xuan25/IR-Controller-AC-YBOF2/Core/Src/main.c

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
/* Includes ------------------------------------------------------------------*/
#include "main.h"
#include "i2c.h"
#include "tim.h"
#include "gpio.h"

/* USER CODE BEGIN Includes */
#include <stdio.h>
#include "aht20.h"
#include "hpt.h"
#include "oled.h"
#include "binary_push_key.h"
#include "pushable_dial.h"

/* USER CODE END Includes */

/* USER CODE BEGIN PD */
#define CMD_INTERVAL 60 * 1000 
#define HT_INTERVAL 1500 
#define HT_READ_DELAY 80
/* USER CODE END PD */


void SystemClock_Config(void);
/* USER CODE BEGIN 0 */
uint32_t cmdOn[] = { 0x9000000A, 0x0004000A };
uint32_t cmdOff[] = { 0x8000000A, 0x0004000B };

uint32_t cmd[2];
uint32_t cmdSegIdx = 0;
uint32_t segBitIdx = 0;

uint64_t lastBitReceivedUs = 0;

uint32_t lastHTMeasureMs = -HT_INTERVAL;
uint32_t lastHTReadMeasureMs = -HT_INTERVAL;

uint32_t lastCmdSentMs = -CMD_INTERVAL;

float tempLower = 26.5;
float tempUpper = 27.5;

BinaryPushKey keys[];
PushableDial dial;

void HAL_GPIO_EXTI_Callback(uint16_t GPIO_Pin)
{
  if(GPIO_Pin == GPIO_PIN_1)
  {
    uint64_t currentUs = HPT_GetUs();
    uint64_t deltaUs = HPT_DeltaUs(lastBitReceivedUs, currentUs);
    lastBitReceivedUs = currentUs;
    if (deltaUs > 4000)
    {
      // beginning of the transmit
      segBitIdx = 0;
      cmdSegIdx++;
      if (cmdSegIdx == 2) {
        cmdSegIdx = 0;
        cmd[0] = 0;
        cmd[1] = 0;
      }
    }
    else if (deltaUs > 1700)
    {
      // bit-1
      if (segBitIdx < 32) {
        segBitIdx++;
        cmd[cmdSegIdx] |= (1UL << (32 - segBitIdx));   // write 1
      }
      
    }
    else if (deltaUs > 1000)
    {
      // bit-0
      if (segBitIdx < 32) {
        segBitIdx++;
        cmd[cmdSegIdx] &= ~(1UL << (32 - segBitIdx));   // write 0
      }
    }
    if (cmdSegIdx == 1 && segBitIdx == 32) {
      cmdSegIdx = 0;
      segBitIdx = 0;
    }
  }
  if (GPIO_Pin == GPIO_PIN_8 || GPIO_Pin == GPIO_PIN_9 || GPIO_Pin == GPIO_PIN_15) {
    PushableDial_Scan(&dial);
  }
}



void setACCmdLevel(uint8_t level) {
  if (level) {
    htim2.Instance->CCR1 = htim2.Instance->ARR / 2;
  } 
  else {
    // htim2.Instance->CCR1 = htim2.Instance->ARR + 1;
    htim2.Instance->CCR1 = 0;
  }
}

void sendACCmdBit(uint8_t bit) {
  if (bit) {
    setACCmdLevel(1);
    HPT_DelayUs(680);
    setACCmdLevel(0);
    HPT_DelayUs(1530);
  } 
  else {
    setACCmdLevel(1);
    HPT_DelayUs(680);
    setACCmdLevel(0);
    HPT_DelayUs(510);
  }
}

void sendACCmd(uint32_t cmd[2]) {

  // start
  setACCmdLevel(1);
  HPT_DelayUs(9010);
  setACCmdLevel(0);
  HPT_DelayUs(4505);

  // seg 1
  for (int i=0; i<32; i++) {
    sendACCmdBit(cmd[0] >> (32 - 1 - i) & 0b1);
  }

  sendACCmdBit(0);
  sendACCmdBit(1);
  sendACCmdBit(0);

  // inter
  setACCmdLevel(1);
  HPT_DelayUs(510);
  setACCmdLevel(0);
  HPT_DelayUs(19975);
  
  // seg 2
  for (int i=0; i<32; i++) {
    sendACCmdBit(cmd[1] >> (32 - 1 - i) & 0b1);
  }

  // end
  setACCmdLevel(1);
  HPT_DelayUs(510);
  setACCmdLevel(0);
  HPT_DelayUs(19975);
  HPT_DelayUs(19975);

  // reset
  setACCmdLevel(0);
}


uint8_t OnKey1StateChanged(struct BinaryPushKey *sender, BinaryPushKeyState state) {
  if (state == PushKeyPressed) {
    sendACCmd(cmdOn);

    uint32_t currentMs = HPT_GetMs();
    lastCmdSentMs = currentMs;
  }
  return 1;
}

uint8_t OnKey2StateChanged(struct BinaryPushKey *sender, BinaryPushKeyState state) {
  if (state == PushKeyPressed) {
    sendACCmd(cmdOff);

    uint32_t currentMs = HPT_GetMs();
    lastCmdSentMs = currentMs;
  }
  return 1;
}

BinaryPushKey keys[] = {
  {
    .Key = &(Key){ },
    .Pin = &(GPIO_Pin){
      .GPIOx = GPIOB,
      .GPIO_Pin = GPIO_PIN_12
    },
    .ReleasedLevel = GPIO_PIN_SET,
    .OnStateChanged = OnKey1StateChanged
  },
  {
    .Key = &(Key){ },
    .Pin = &(GPIO_Pin){
      .GPIOx = GPIOB,
      .GPIO_Pin = GPIO_PIN_13
    },
    .ReleasedLevel = GPIO_PIN_SET,
    .OnStateChanged = OnKey2StateChanged
  },
};

uint8_t OnPressedDialTicked(struct PushableDial *sender, int8_t direction) {
  if (tempUpper - tempLower > 0.2 || direction < 0) {
    float delta = direction > 0 ? 0.1 : -0.1;
    tempLower += delta;
    tempUpper -= delta;
  }
}

uint8_t OnReleasedDialTicked(struct PushableDial *sender, int8_t direction) {
  float delta = direction > 0 ? 0.1 : -0.1;
  tempLower -= delta;
  tempUpper -= delta;
}

uint8_t OnPushKeyStateChanged(struct PushableDial *sender, BinaryPushKeyState state, uint8_t isDialTicked) {

}

PushableDial dial = {
  .PressedDial = &(Dial) {
    .Encoder = &(Encoder) {
      .OffLevel = GPIO_PIN_SET,
      .PinA = &(GPIO_Pin) {
        .GPIOx = GPIOA,
        .GPIO_Pin = GPIO_PIN_8
      },
      .PinB = &(GPIO_Pin) {
        .GPIOx = GPIOA,
        .GPIO_Pin = GPIO_PIN_9
      },
    },
    .TickInterval = 3
  },
  .ReleasedDial = &(Dial) {
    .Encoder = &(Encoder) {
      .OffLevel = GPIO_PIN_SET,
      .PinA = &(GPIO_Pin) {
        .GPIOx = GPIOA,
        .GPIO_Pin = GPIO_PIN_8
      },
      .PinB = &(GPIO_Pin) {
        .GPIOx = GPIOA,
        .GPIO_Pin = GPIO_PIN_9
      },
    },
    .TickInterval = 3
  },
  .PushKey = &(BinaryPushKey){
    .Key = &(Key){ },
    .Pin = &(GPIO_Pin){
      .GPIOx = GPIOB,
      .GPIO_Pin = GPIO_PIN_15
    },
    .ReleasedLevel = GPIO_PIN_SET
  },
  .OnPressedDialTicked = OnPressedDialTicked,
  .OnReleasedDialTicked = OnReleasedDialTicked,
  .OnPushKeyStateChanged = OnPushKeyStateChanged
};

/* USER CODE END 0 */

/**
  * @brief  The application entry point.
  * @retval int
  */
int main(void)
{
  /* MCU Configuration--------------------------------------------------------*/

  /* Reset of all peripherals, Initializes the Flash interface and the Systick. */
  HAL_Init();

  /* Configure the system clock */
  SystemClock_Config();

  /* Initialize all configured peripherals */
  MX_GPIO_Init();
  MX_I2C1_Init();
  MX_TIM2_Init();
  /* USER CODE BEGIN 2 */

  HAL_Delay(100);

  AHT20_Init();

  OLED_Init();
  OLED_PlotString(0, 16, "Loading...", OLED_FONT_1608, OLED_PLOTTING_FILL, OLED_BACKGROUND_FILL);
  OLED_Flush();

  setACCmdLevel(0);
  HAL_TIM_PWM_Start(&htim2, TIM_CHANNEL_1);

  HAL_Delay(3000);

  /* USER CODE END 2 */

  /* Infinite loop */
  /* USER CODE BEGIN WHILE */
  float humidity = 0.0, temperature = 0.0;
  uint8_t hasHTReading = 0;
  char text_buf[50] = {0};
  uint8_t lastCmd = 0;

  for (int i = 0; i < sizeof(keys)/sizeof(BinaryPushKey); i++) {
    BinaryPushKey_Init(&keys[i]);
  }
  PushableDial_Init(&dial);

  while (1)
  {
    /* USER CODE END WHILE */

    /* USER CODE BEGIN 3 */

    for (int i = 0; i < sizeof(keys)/sizeof(BinaryPushKey); i++) {
      BinaryPushKey_Scan(&keys[i]);
    }
    
    uint32_t currentMs = HPT_GetMs();

    // HT
    if (HPT_DeltaMs(lastHTMeasureMs, currentMs) >= HT_INTERVAL) {
      AHT20_Measure();
      lastHTMeasureMs = currentMs;
    }

    if (lastHTReadMeasureMs != lastHTMeasureMs && HPT_DeltaMs(lastHTMeasureMs, currentMs) >= HT_READ_DELAY) {
      AHT20_Read(&temperature, &humidity);
      lastHTReadMeasureMs = lastHTMeasureMs;
      hasHTReading = 1;
    }

    // command
    uint32_t cmdSentDeltaMs = HPT_DeltaMs(lastCmdSentMs, currentMs);
    if (hasHTReading) {
      if (cmdSentDeltaMs >= CMD_INTERVAL) {
        if (temperature > tempUpper) {
          sendACCmd(cmdOn);
          lastCmdSentMs = currentMs;
          lastCmd = 1;
        }
        if (temperature < tempLower) {
          sendACCmd(cmdOff);
          lastCmdSentMs = currentMs;
          lastCmd = 0;
        }
      }
    }
    
    

    // canvas
    OLED_ClearBuffer();

    sprintf(text_buf, "L: %.1f", tempLower);
    OLED_PlotString(0, 8, text_buf, OLED_FONT_0806, OLED_PLOTTING_FILL, OLED_BACKGROUND_FILL);
    sprintf(text_buf, "U: %.1f", tempUpper);
    OLED_PlotString(64-8, 8, text_buf, OLED_FONT_0806, OLED_PLOTTING_FILL, OLED_BACKGROUND_FILL);

    sprintf(text_buf, "T: %.2f", temperature);
    OLED_PlotString(0, 16, text_buf, OLED_FONT_1608, OLED_PLOTTING_FILL, OLED_BACKGROUND_FILL);
    sprintf(text_buf, "H: %.2f", humidity);
    OLED_PlotString(64+8, 16+8, text_buf, OLED_FONT_0806, OLED_PLOTTING_FILL, OLED_BACKGROUND_FILL);
    
    if (lastCmd) {
      sprintf(text_buf, "L: On", cmdSentDeltaMs);
    } else {
      sprintf(text_buf, "L: Off", cmdSentDeltaMs);
    }
    OLED_PlotString(0, 40, text_buf, OLED_FONT_0806, OLED_PLOTTING_FILL, OLED_BACKGROUND_FILL);
    if (cmdSentDeltaMs >= CMD_INTERVAL) {
      sprintf(text_buf, "D: -----", cmdSentDeltaMs);
    } else {
      sprintf(text_buf, "D: %.5d", cmdSentDeltaMs);
    }
    OLED_PlotString(64, 40, text_buf, OLED_FONT_0806, OLED_PLOTTING_FILL, OLED_BACKGROUND_FILL);
    
    sprintf(text_buf, "C: %0.8X %0.8X", cmd[0], cmd[1]);
    OLED_PlotString(0, 56, text_buf, OLED_FONT_0806, OLED_PLOTTING_FILL, OLED_BACKGROUND_FILL);

    OLED_Flush();
  }
  /* USER CODE END 3 */
}

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
