xuan25/IR-Controller-AC-YBOF2/ACController.ioc

Mcu.UserName=STM32F103C8Tx
PA13.Signal=SYS_JTMS-SWDIO
PA14.Signal=SYS_JTCK-SWCLK
PA15.Signal=S_TIM2_CH1_ETR
PA8.Signal=GPXTI8
PA9.Signal=GPXTI9
PB1.Signal=GPXTI1
PB12.Signal=GPIO_Input
PB13.Signal=GPIO_Input
PB15.Signal=GPXTI15
PB3.Signal=SYS_JTDO-TRACESWO
PB6.Signal=I2C1_SCL
PB7.Signal=I2C1_SDA
PD0-OSC_IN.Signal=RCC_OSC_IN
PD1-OSC_OUT.Signal=RCC_OSC_OUT
