xuan25/IR-Controller-AC-YBOF2/IO/Inc/encoder.h

/**
  ******************************************************************************
  * @file    encoder.h
  * @brief   
  ******************************************************************************
  * @attention
  *
  * Copyright (c) 2023 Xuan25.
  * All rights reserved.
  *
  * This software is licensed under terms that can be found in the LICENSE file
  * in the root directory of this software component.
  * If no LICENSE file comes with this software, it is provided AS-IS.
  *
  ******************************************************************************
  */

#ifndef __ENCODER_H
#define __ENCODER_H

#ifdef __cplusplus
extern "C" {
#endif

#include "stm32f1xx_hal.h"
#include "gpio_pin.h"

enum Encoder_Edge;
struct Encoder_Internal;
struct Encoder;

// Low-pass debouncing filter config for encoder pins. 
// Should be greater than the half of the bouncing period in microseconds
// ((1 / frequency) / 2)
#define ENCODER_DEBOUNCE_US 0u

/**
 * @brief Pin which rising/falling edge occurred.
*/
typedef enum Encoder_Edge
{
  ENCODER_EDGE_A = 1 << 0,
  ENCODER_EDGE_B = 1 << 1,
}Encoder_Edge;

typedef struct Encoder_Internal {
  void *Parent;                       // Parent
#if ENCODER_DEBOUNCE_US > 0
  uint64_t LastLevelChangedUs;        // Time of the last level change on either pin
  uint8_t LastChangedLevelA;          // Last voltage level of Pin A
  uint8_t LastChangedLevelB;          // Last voltage level of Pin B
#endif
  uint8_t LastStateA;                 // Last pin state of Pin A
  uint8_t LastStateB;                 // Last pin state of Pin B

  /**
   * @brief Tick callback of the encoder (parent)
   * 
   * @param sender Encoder that trigger the callback.
   * @param direction Tick direction. Positive for CW. Negative for CCW.
   * @param edge Pin which rising/falling edge occurred.
   * @retval None
  */
  void (*OnTicked)(struct Encoder *sender, int8_t direction, Encoder_Edge edge);
} Encoder_Internal;

/**
 * @brief Encoder Structure definition
 * 
 * @note Used to manage a encoder hardware.
*/
typedef struct Encoder {
  Encoder_Internal Internal;          // For internal usage
  GPIO_Pin *PinA;                     // GPIO Pin A
  GPIO_Pin *PinB;                     // GPIO Pin B
  GPIO_PinState OffLevel;             // GPIO pin level for OFF state of encoder pin

  /**
   * @brief Tick callback of the encoder
   * 
   * @param sender Encoder that trigger the callback.
   * @param direction Tick direction. Positive for CW. Negative for CCW.
   * @param edge Pin which rising/falling edge occurred.
   * @retval Whether the event has been handled. 
   * Once the event has been handled, it will not been sent to its parent.
  */
  uint8_t (*OnTicked)(struct Encoder *sender, int8_t direction, Encoder_Edge edge);
} Encoder;

/**
 * @brief Initialize an encoder
 * 
 * @param encoder The encoder to be initialized
 * @retval None
*/
void Encoder_Init(Encoder *encoder);

/**
 * @brief Scan an encoder hardware to update its state and potentially trigger a callback.
 * 
 * @param encoder The encoder to be scanned
 * @retval None
*/
void Encoder_Scan(Encoder *encoder);

#ifdef __cplusplus
}
#endif

#endif /* __KEY_H */
