xuan25/IR-Controller-AC-YBOF2/(commit log)

2023-07-20 temperature & humidity
2023-07-20 Button on & off
2023-07-21 change i2c to fast mode
2023-07-21 Reset D after cmd been sent manually
    [main.c]
2023-07-21 Move IR input pin to PB1
2023-07-21 Move IR output pin to PA15
2023-07-26 reverse PWM duty
